navee-singh/PoolNoodleKickTrainer/stl/cross_pin.stl

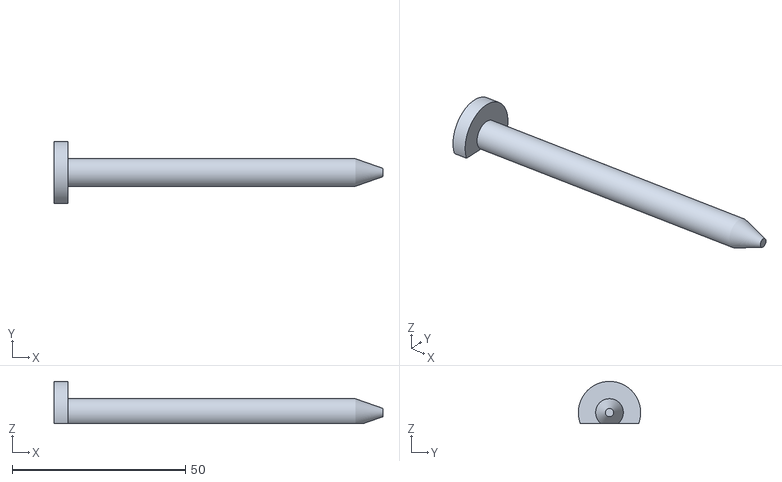
[picture p1: CAD file, 2026-10-14]
stl/cross_pin.stl
95.0 x 18.0 x 12.2
