navee-singh/PoolNoodleKickTrainer/stl/noodle_mount.stl

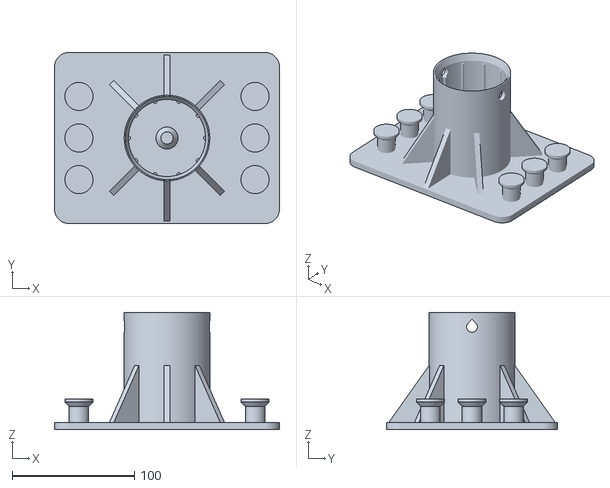
[picture p2: CAD file, 2026-10-14]
stl/noodle_mount.stl
184.0 x 140.0 x 96.0
