navee-singh/PoolNoodleKickTrainer/stl/hanger_x4.stl

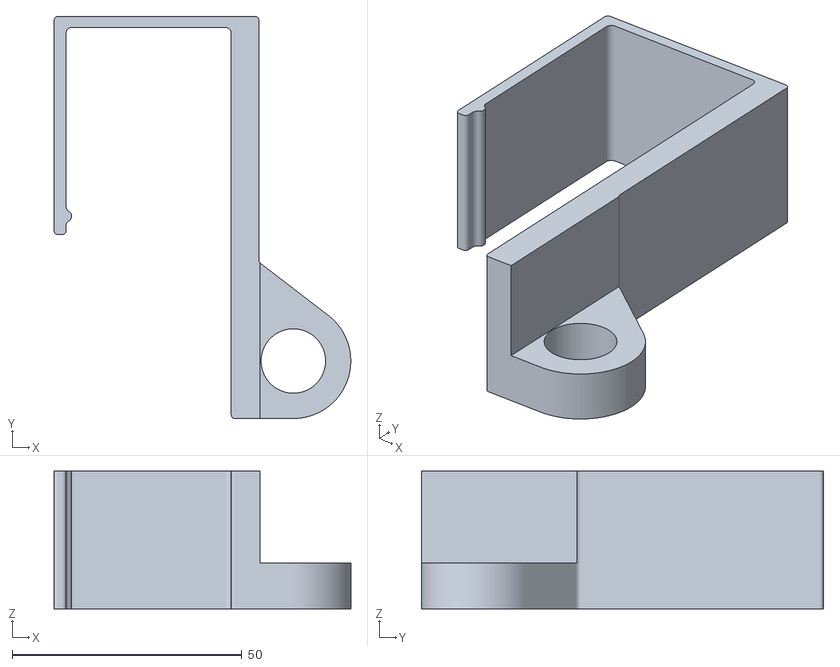
[picture p3: CAD file, 2026-10-14]
stl/hanger_x4.stl
64.5 x 87.4 x 30.0
